japeral/Bedinino/hw/components/Jack Barrel to screw adapter, arduino power from wires/barrel jack adapter to screw.JPG

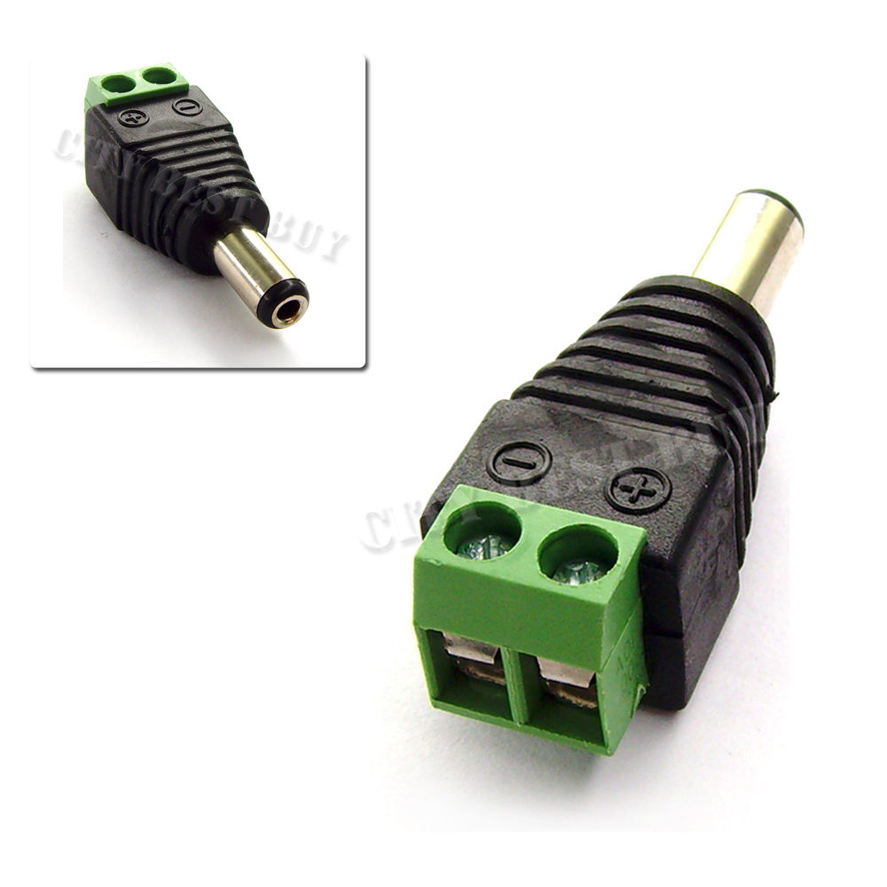
hw/components/Jack Barrel to screw adapter, arduino power from wires/barrel jack adapter to screw.JPG
