japeral/Bedinino/hw/components/Deepcycle Lead GEL Battery/Xuncell 12V 8Ah Solarx.jpg

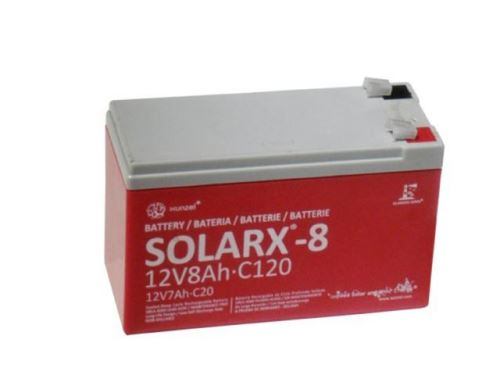
hw/components/Deepcycle Lead GEL Battery/Xuncell 12V 8Ah Solarx.jpg
