japeral/Bedinino/sw/Bedinino_timedbatteryswitcher_4x20LCD_4xDPDT/Bedinino TimedBatterySwitcher_schematic_4x20LCD_4xDPDT.docx

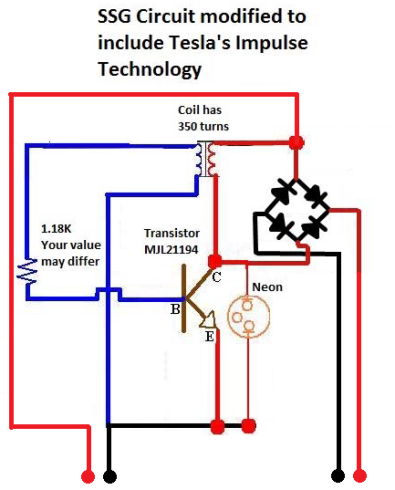
[picture p3: figure]

Output (Secondary)

Input (Primary)

B4

B3

B2

B1

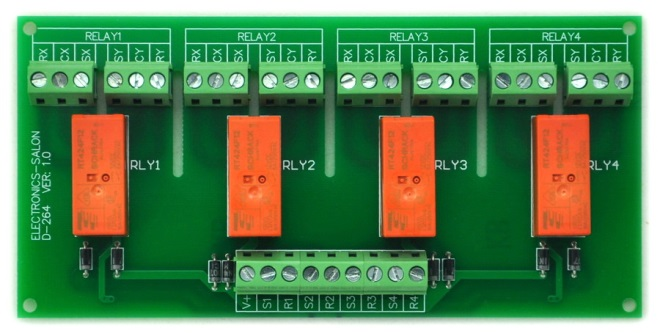
[picture p4: figure]

Isolation barrier

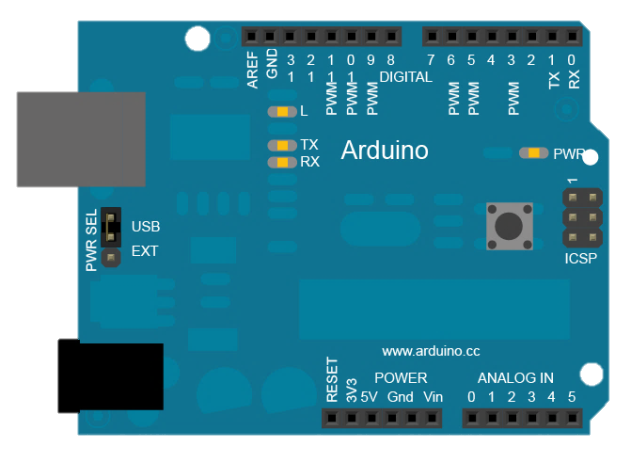
[picture p5: figure]

5V/1A USB Power Supply

For Arduino & Relays power

You need:

-Arduino UNO with this code:

(TODO)

- 1x latching 4x relay DPDT 8A 5V module.

Ebay: http://www.ebay.es/itm/131232400622?ssPageName=STRK:MEWAX:IT&_trksid=p3984.m1423.l2649

-Your Bedini monopole motor/energizer assembly and 4 batteries.

By J.A. Peral, 2014-07-12. japeralsoler@gmail.com It is a part of Bedinino project: www.github.com/japeral/Bedinino

Bedinino – Timed Battery Switcher +4x20LCD +4xDPDT v1.30
