japeral/Bedinino/sw/Bedinino_timedbatteryswitcher/Bedinino TimedBatterySwitcher_schematic.pdf

## Bedinino – Timed Battery Switcher v1.00

## Bedini monopole

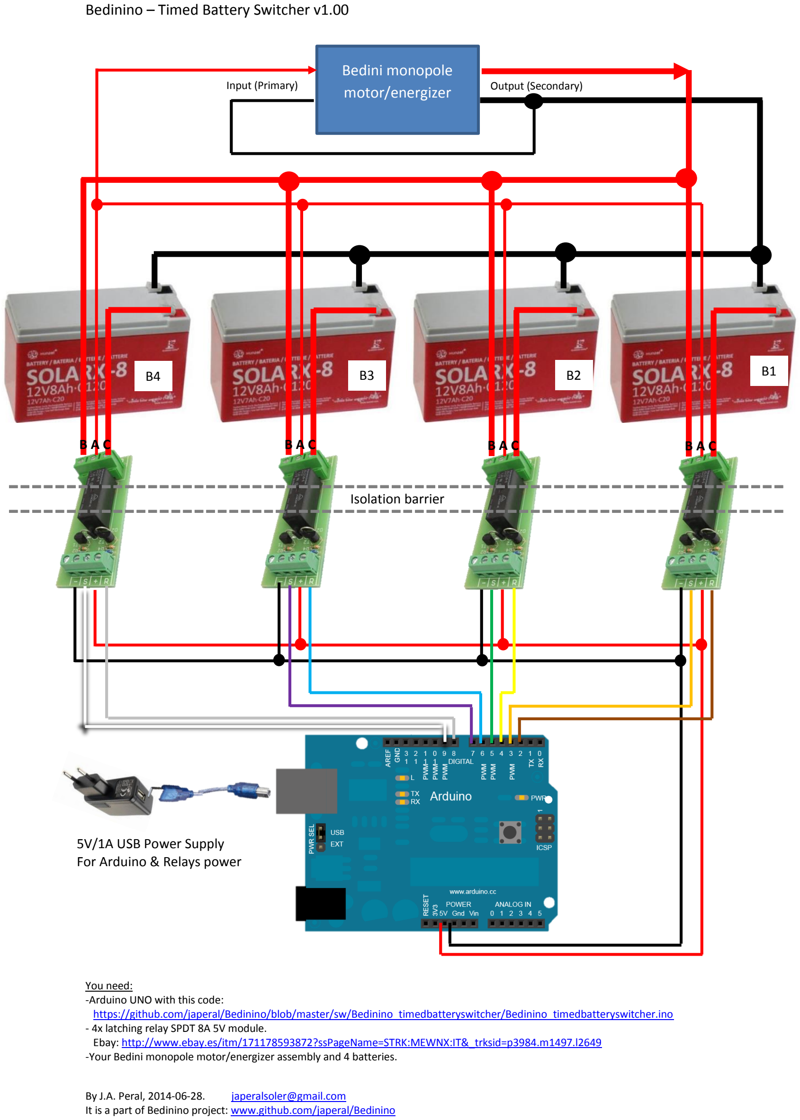
[picture p6: page 1]

By J.A. Peral, 2014-06-28. japeralsoler@gmail.com
It is a part of Bedinino project: www.github.com/japeral/Bedinino

You need:
-Arduino UNO with this code: https://github.com/japeral/Bedinino/blob/master/sw/Bedinino_timedbatteryswitcher/Bedinino_timedbatteryswitcher.ino
- 4x latching relay SPDT 8A 5V module.
Ebay: http://www.ebay.es/itm/171178593872?ssPageName=STRK:MEWNX:IT&_trksid=p3984.m1497.l2649
-Your Bedini monopole motor/energizer assembly and 4 batteries.
motor/energizer Input (Primary) | Output (Secondary)
B A C | B A C | B A C | B A C
B4 | B3 | B2

B1

### Isolation barrier

### 5V/1A USB Power Supply For Arduino & Relays power
