japeral/Bedinino/hw/components/Arduino uno ATMEGA328P pinout/ATMega168web.png

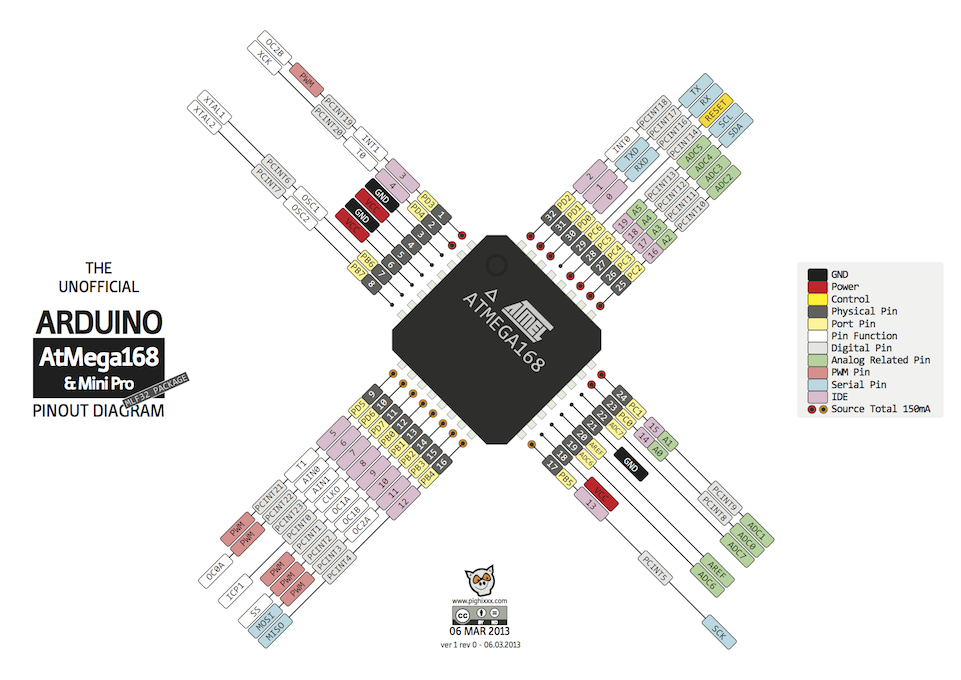
hw/components/Arduino uno ATMEGA328P pinout/ATMega168web.png
