japeral/Bedinino/hw/components/Magnetic sensor ratiometric/pinout & active area.jpg

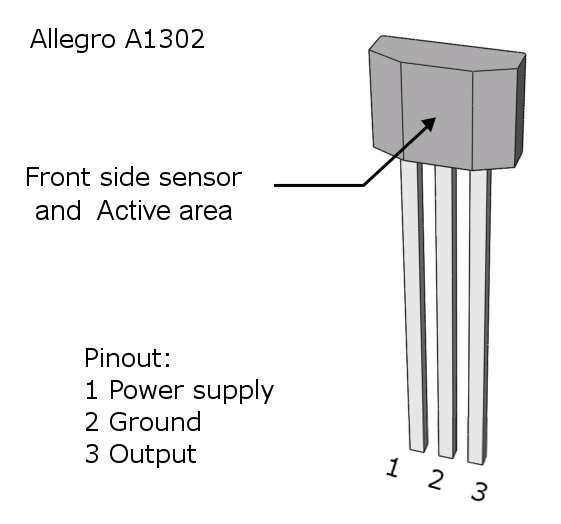
hw/components/Magnetic sensor ratiometric/pinout & active area.jpg
