japeral/Bedinino/hw/misc/12978_317747994994420_1342889042_n.jpg

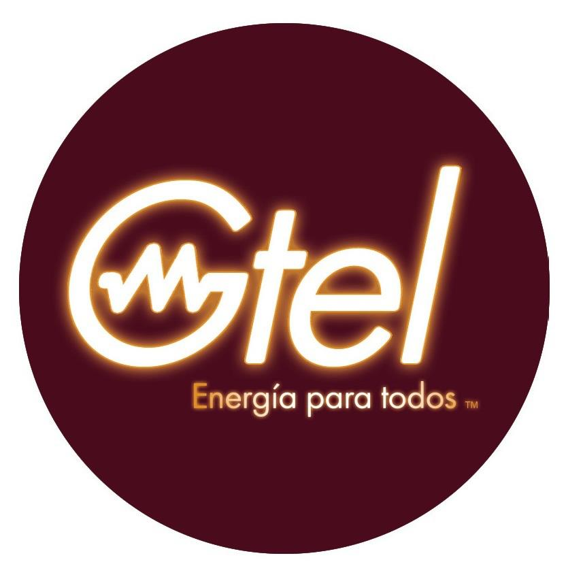
hw/misc/12978_317747994994420_1342889042_n.jpg
