japeral/Bedinino/hw/misc/gtel mono.bmp

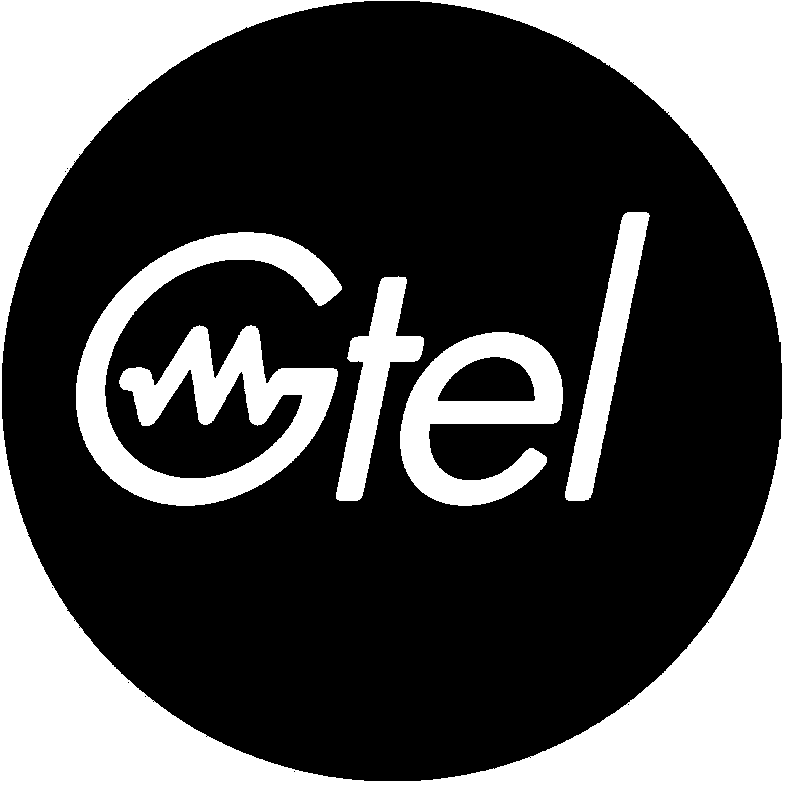
hw/misc/gtel mono.bmp
