japeral/Bedinino/hw/pcb/4 Battery Swap Shield (4BSS) rev.A/rev.A/4BSS rev.A v1/4BSS rev.A preview.png

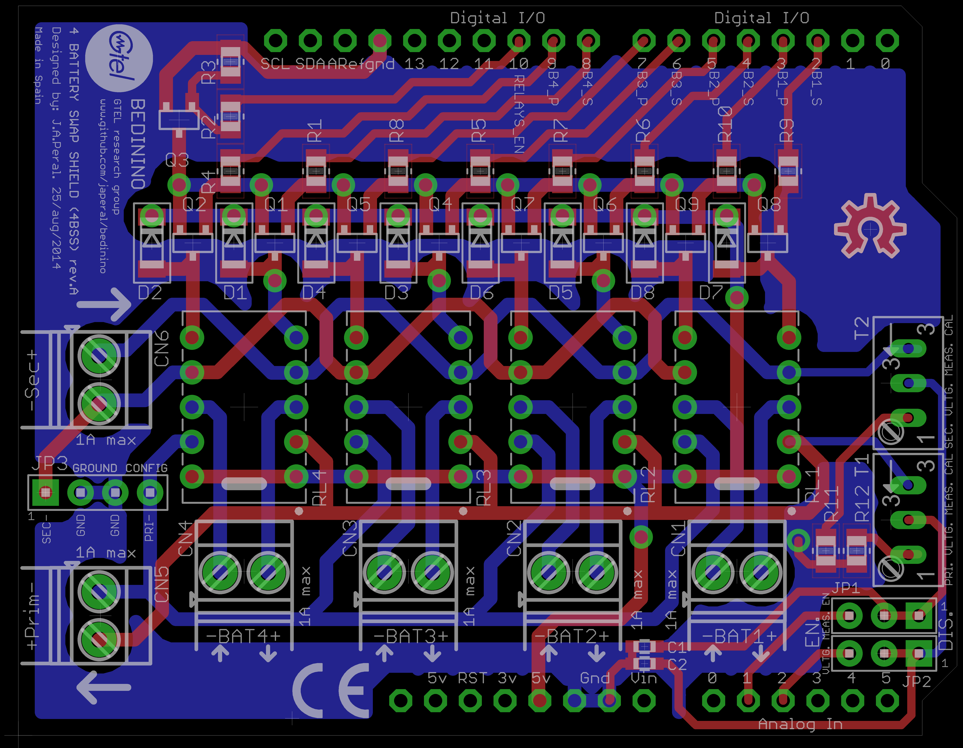
hw/pcb/4 Battery Swap Shield (4BSS) rev.A/rev.A/4BSS rev.A v1/4BSS rev.A preview.png
