japeral/Bedinino/hw/pcb/4 Battery Swap Shield (4BSS) rev.A/rev.A/4BSS rev.A v1/4bss rev.A TOP.png

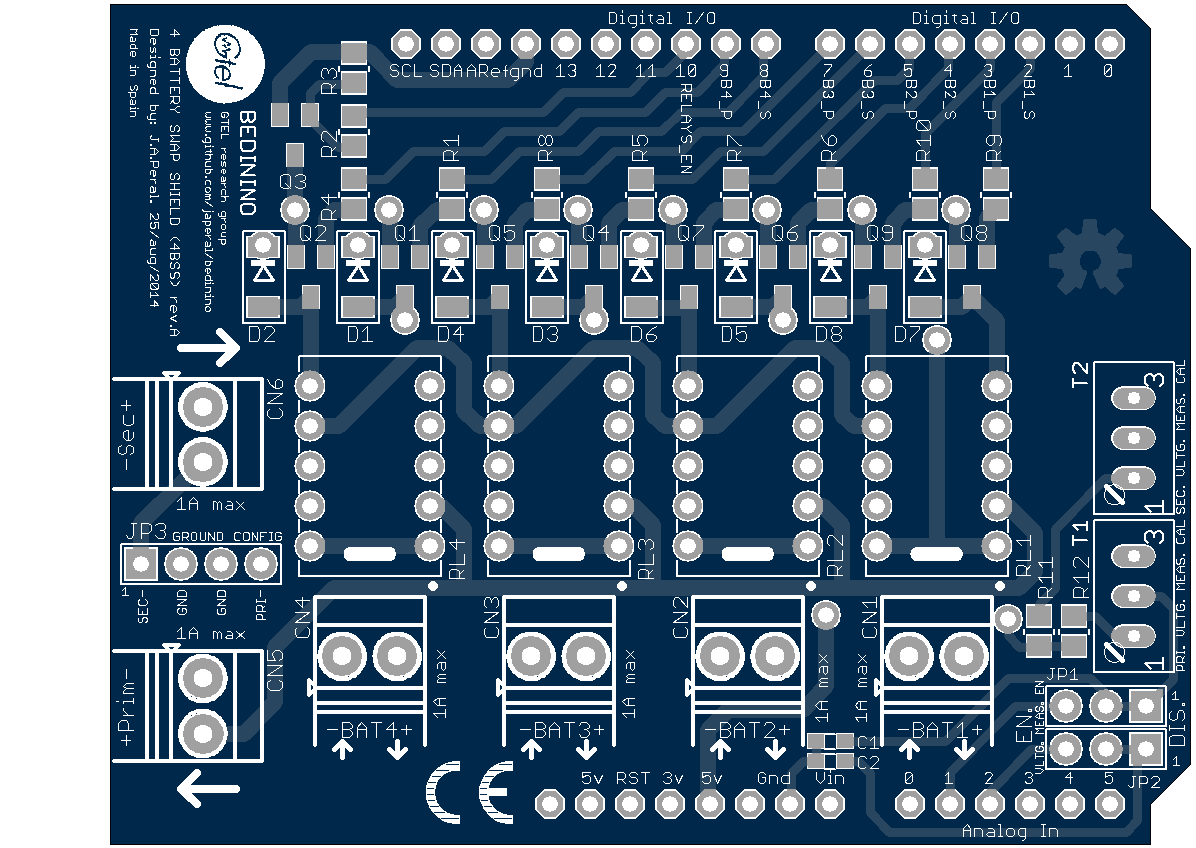
hw/pcb/4 Battery Swap Shield (4BSS) rev.A/rev.A/4BSS rev.A v1/4bss rev.A TOP.png
