japeral/Bedinino/hw/pcb/4 Battery Swap Shield (4BSS) rev.A/rev.A/Bedinino 4BSS schematic ebay.PNG

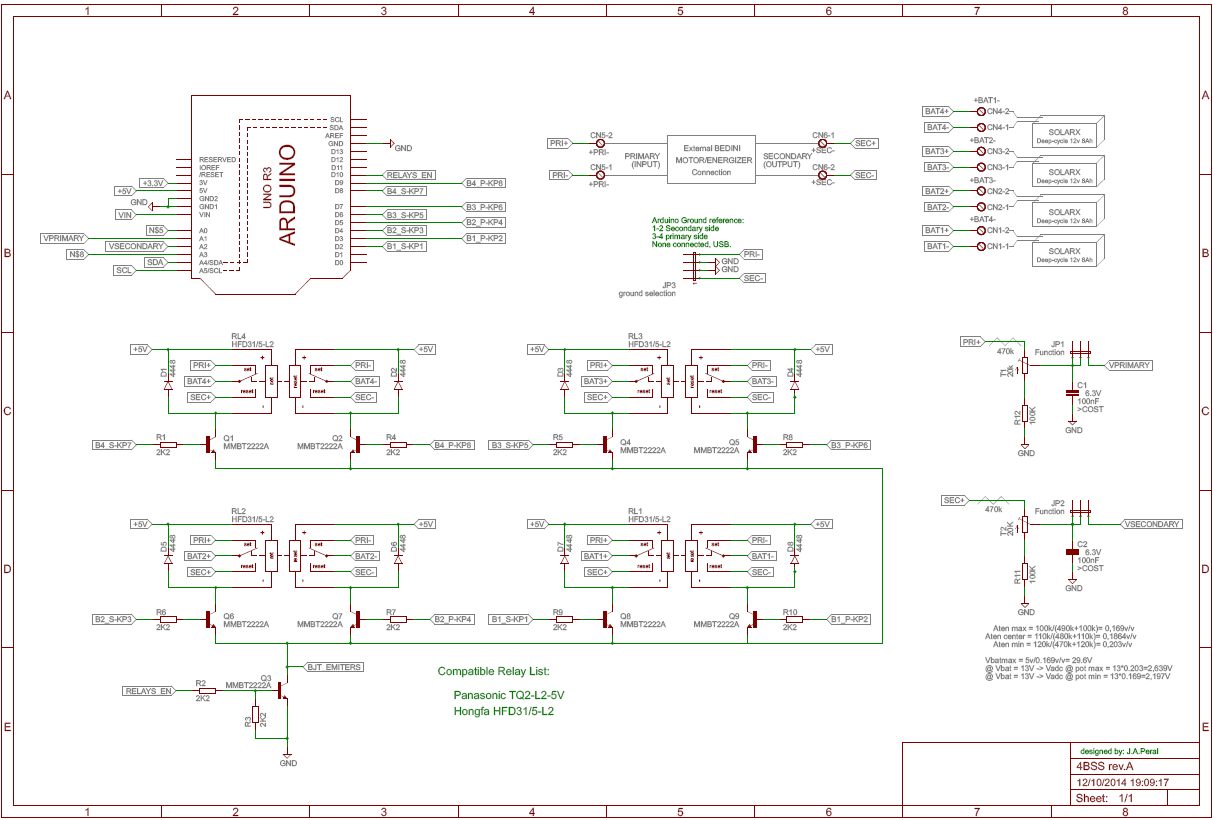
hw/pcb/4 Battery Swap Shield (4BSS) rev.A/rev.A/Bedinino 4BSS schematic ebay.PNG
