japeral/Bedinino/sw/Bedinino_4BSS_4x20LCD_TACHO/Bedinino_4BSS_4x20LCD_TACHO_v1.33/pinout & active area.jpg

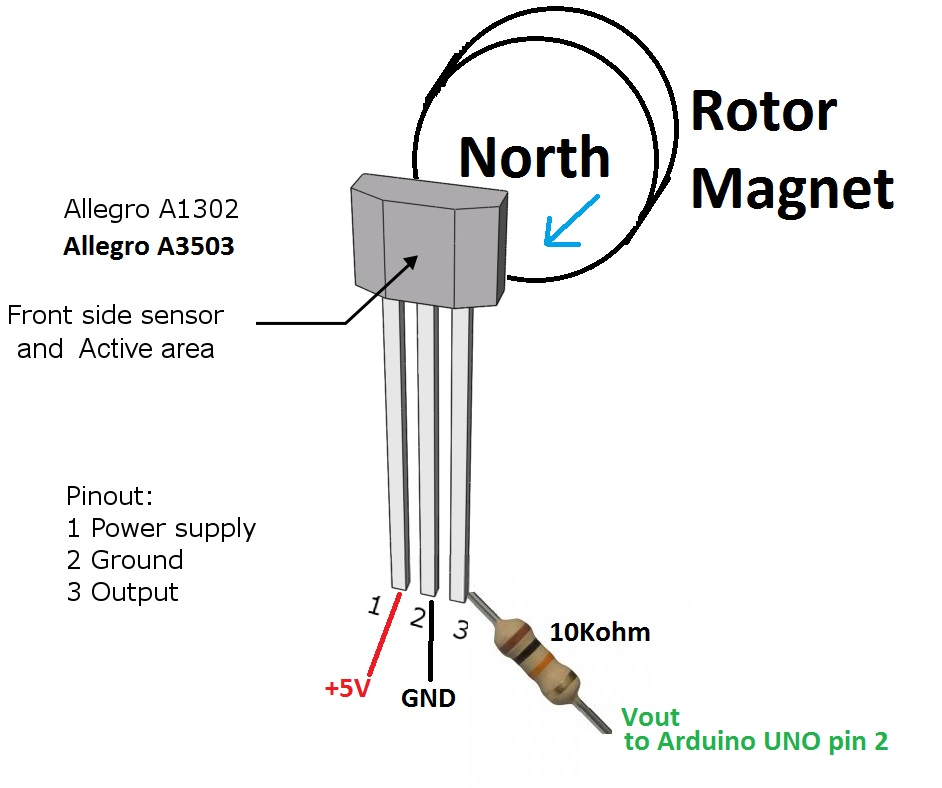
sw/Bedinino_4BSS_4x20LCD_TACHO/Bedinino_4BSS_4x20LCD_TACHO_v1.33/pinout & active area.jpg
