japeral/Bedinino/sw/Bedinino_timedbatteryswitcher/Bedini sugiere circuito que intercambia 4 baterias.PNG

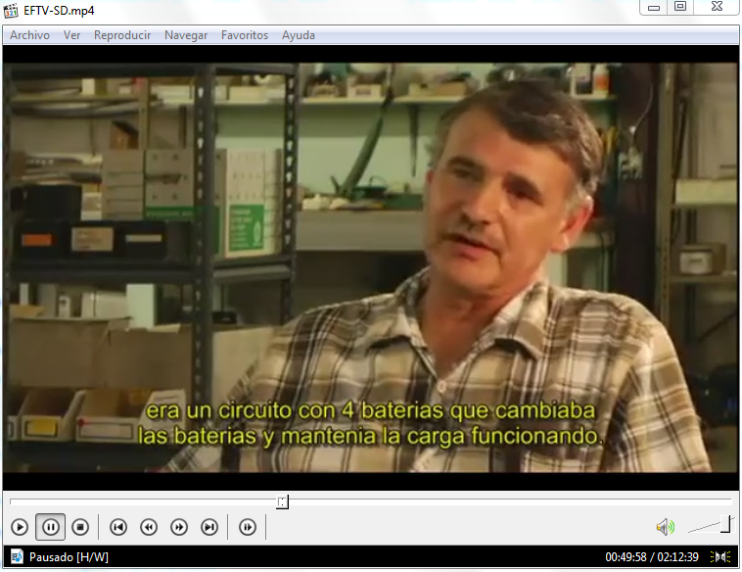
sw/Bedinino_timedbatteryswitcher/Bedini sugiere circuito que intercambia 4 baterias.PNG
