japeral/Bedinino/sw/Bedinino_timedbatteryswitcher_4x20LCD_4xDPDT/Bedinino v1.30.png

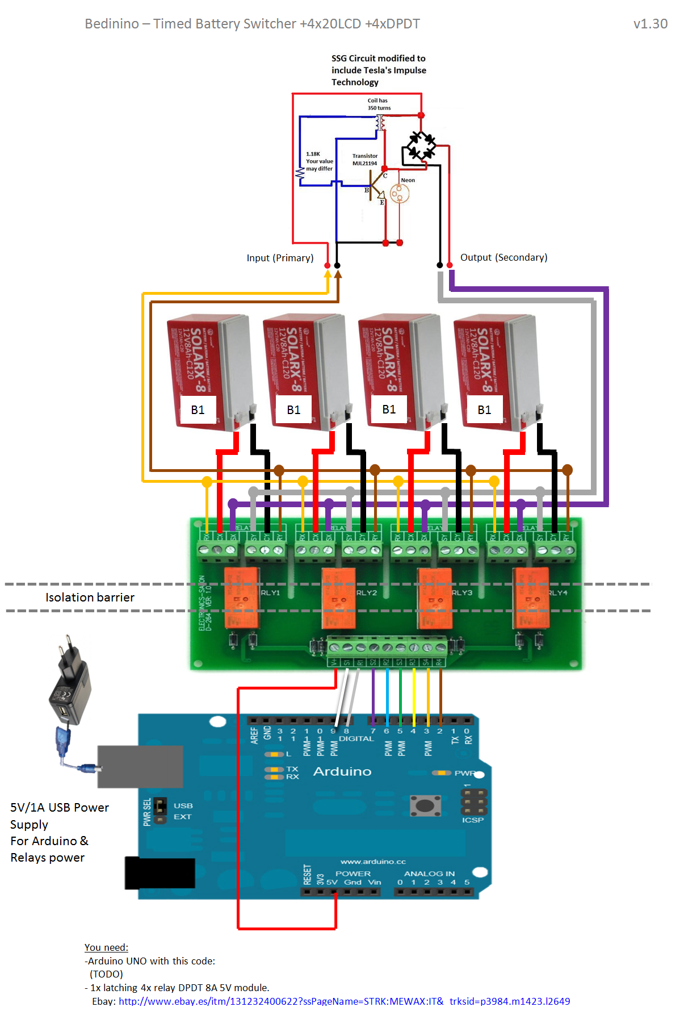
sw/Bedinino_timedbatteryswitcher_4x20LCD_4xDPDT/Bedinino v1.30.png
