japeral/Bedinino/sw/Bedinino_timedbatteryswitcher_4x20LCD_4xDPDT/D-262SCH.jpg

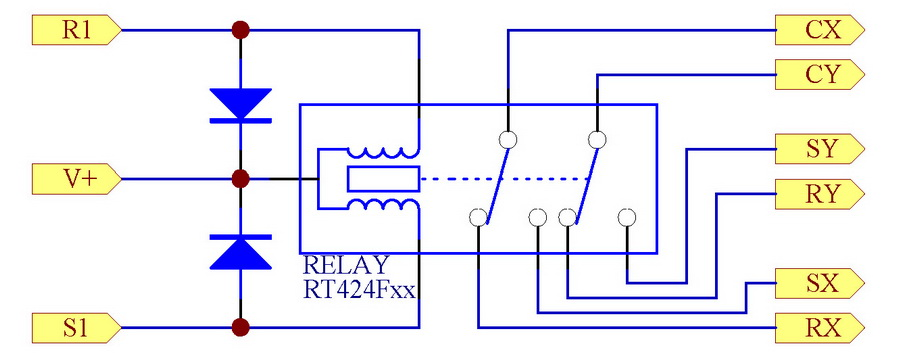
sw/Bedinino_timedbatteryswitcher_4x20LCD_4xDPDT/D-262SCH.jpg
