japeral/Bedinino/sw/Bedinino_timedbatteryswitcher_4x20LCD_4xDPDT/Passive Bistable Latching 4 DPDT 8 Amp Power Relay Module, 5V Version, RT424F05   eBay_files/spr15.png

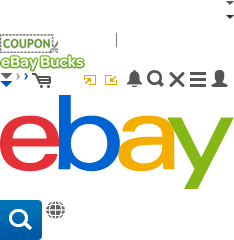
sw/Bedinino_timedbatteryswitcher_4x20LCD_4xDPDT/Passive Bistable Latching 4 DPDT 8 Amp Power Relay Module, 5V Version, RT424F05 eBay_files/spr15.png
