japeral/Bedinino/hw/Bill of Materials.xlsx

Description | Cost/pc | Number | Total
Arduino uno Clone | 5.43 € | 1 | 5.43 € | http://www.ebay.es/itm/NEW-CH340G-ATmega328P-UNO-R3-Board-Free-USB-Cable-for-Arduino-DIY-/141248769799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
DC/DC Buck converter | 1 € | 1 | 1 | http://www.ebay.es/itm/1pcs-DC-DC-Buck-Converter-Step-Down-Module-LM2596-Power-Supply-Output-1-23V-30V-/161102182049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
Latching Bistable Relay 5V | 7.33 € | 4 | 29.32 € | http://www.ebay.es/itm/Latching-Bistable-Relay-module-5V-Relay-board-for-AVR-PIC-Arduino-from-EU-/171178593872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
Arduino Uno Screw Shield | 3.37 € | 1 | 3.37 € | http://www.ebay.es/itm/Arduino-Screw-Shield-V1-expansion-board-set-for-DIY-is-compatible-with-UNO-R3-/271315401783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
Male-female 40 cable kit | 1.47 € | 1 | 1.47 € | http://www.ebay.es/itm/40pcs-20cm-2-54mm-Male-to-Female-Dupont-Wire-Jumper-Cable-for-Arduino-Breadboard-/360821413280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
Magnetic Sensor Hall effect ratiometric | 3.29 € | 5 | 0.66 € | http://www.ebay.es/itm/5Pcs-A1302-NEW-Ratiometric-Linear-Hall-Effect-Sensors-Chip-/310884565551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
Jack Barrel to screw adapter | 1.06 € | 2 | 0.53 € | http://www.ebay.es/itm/2-pcs-Male-5-5-x-2-1mm-DC-Power-Connector-Adapter-Jack-Plug-for-CCTV-Camera-/351092210138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
 |  | TOTAL | 41.78 €
Optional
12V 8Ah Deep cycle Gel / VRLA | 21.95 € | 2 | 43.90 € | http://www.ebay.es/itm/BATERIA-REFERENCIA-YPC8-12-DE-8AH-12V-BATERIA-DE-CALIDAD-YUASA-/181251963659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
Recomended equipment
M168 DIY Multimeter (inductance, capacitance, transistor… | 10.85 € | 1 | 10.85 € | http://www.ebay.es/itm/DIY-Kit-Capacitance-ESR-Inductance-Resistor-LC-Meter-Tester-NPN-PNP-Mosfet-M168-/281262386306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
Laser Photo Tachometer RMP Tester | 8.62 € | 1 | 8.62 € | http://www.ebay.es/itm/New-Digital-Laser-Photo-Tachometer-Non-Contact-RPM-Tach-Tester-RPM-Motors-/161114545438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
200mA analog ampmeter | 3.59 € | 2 | 7.18 € | http://www.ebay.es/itm/DC-200mA-Ampmeter-Analog-Current-Panel-Meter-Ammeter-0-200mA-/271210797555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
