japeral/Bedinino/hw/pcb/4 Battery Swap Shield (4BSS) rev.A/rev.A/4BSS rev.A Bill of Materials BOM.xls

Qty | Value | Device | Package | Parts | Description
6 | 1776275-2 |  | 3.5MMPITCH_2WAY | CN4 | CONNECTOR, Terminal Block, 2 pos, Side entry, Screw, 3.5mm pitch
1 | 3296W-1-204LF | 3296W-1-204LF | W | T1 | POTENTIOMETER, Trimmer, Square, Multiturn, 25 +-2 Turn, Cermet, Top Adjustment, 3/8''
1 | 3296W-1-503LF | 3296W-1-503LF | W | T2 | POTENTIOMETER, Trimmer, Square, Multiturn, 25 +-2 Turn, Cermet, Top Adjustment, 3/8''
2 |  |  | 0603 | C1, C2 | CAPACITOR, 100nF, 50V, 0603, Ceramic multilayer, X7R, 10%
4 | HFD31/5-L2 | HFD31/5-L2 | HFD31 | RL1, RL2, RL3, RL4 | Subminiature dual coil latching signal relay
8 | LS4448 | LS4448 | SOD-80C | D1, D2, D3, D4, D5, D6, D7, D8 | DIODE, Small signal, fast switching, IFSM=2A, IFRM=500mA, IF=300mA, SOD-80C
9 | MMBT2222A | MMBT2222A | SOT23 | Q1, Q2, Q3, Q4, Q5, Q6, Q7, Q8, Q9 | TRANSISTOR, BJT, NPN, General Purpose, Idmax=600, Vcemax=40V
2 |  |  | 0805 | R11, R12 | RESISTOR, General purpose resistor, 5%, 200v, 100ppm/ºC
10 |  |  | 0805 | R1, R2, R3, R4, R5, R6, R7, R8, R9, R10 | RESISTOR, General purpose resistor, 5%, 200v, 100ppm/ºC
2 |  |  | 3WAY-2.54MM | JP1, JP2 | HEADER MALE PIN, 1Row, 3 Way.
1 |  |  | 4WAY-2.54MM | JP3 | HEADER MALE PIN, 1Row, 4 Way.
