japeral/Bedinino/hw/components/Deepcycle Lead GEL Battery/Yuasa 12V 8Ah GEL Deepcycle YPC-12.JPG

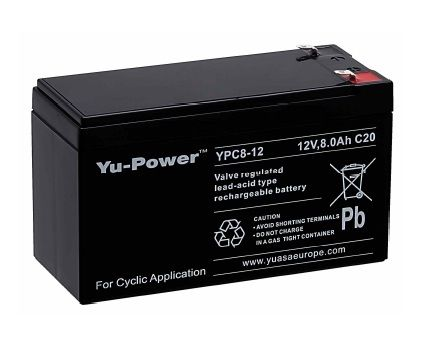
hw/components/Deepcycle Lead GEL Battery/Yuasa 12V 8Ah GEL Deepcycle YPC-12.JPG
