japeral/Bedinino/hw/pcb/4 Battery Swap Shield (4BSS) rev.A/rev.A/4BSS rev.A Schematic.pdf

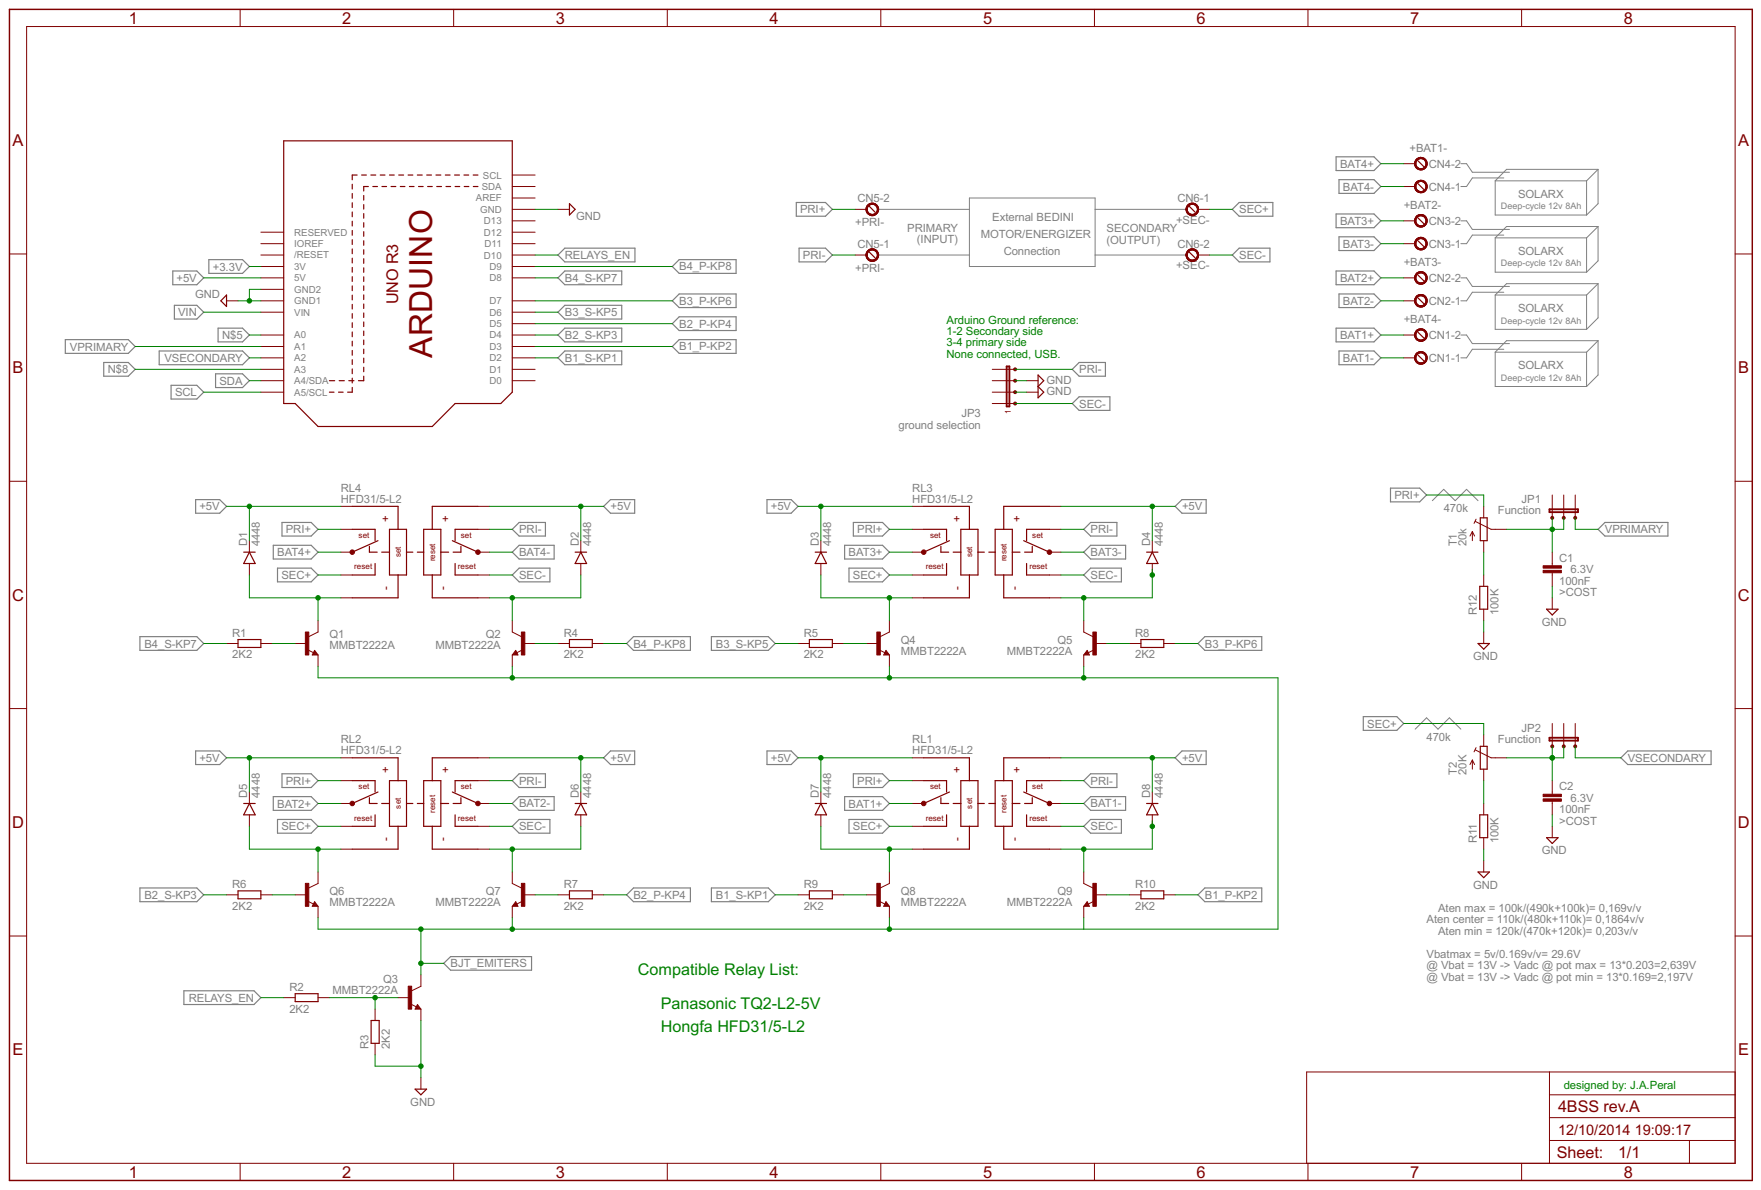
[picture p27: page 1]

External BEDINI MOTOR/ENERGIZER

Arduino Ground reference: None connected, USB. 1-2 Secondary side

Aten min = 120k/(470k+120k)= 0,203v/v Aten max = 100k/(490k+100k)= 0,169v/v @ Vbat = 13V -> Vadc @ pot min = 13*0.169=2,197V
Aten center = 110k/(480k+110k)= 0,1864v/v

Vbatmax = 5v/0.169v/v= 29.6V
@ Vbat = 13V -> Vadc @ pot max = 13*0.203=2,639V

Compatible Relay List: Panasonic TQ2-L2-5V
