japeral/Bedinino/hw/pcb/4 Battery Swap Shield (4BSS) rev.A/rev.A/4BSS rev.A.sch

## EAGLE design hw/pcb/4 Battery Swap Shield (4BSS) rev.A/rev.A/4BSS rev.A.sch (2014-10-12)

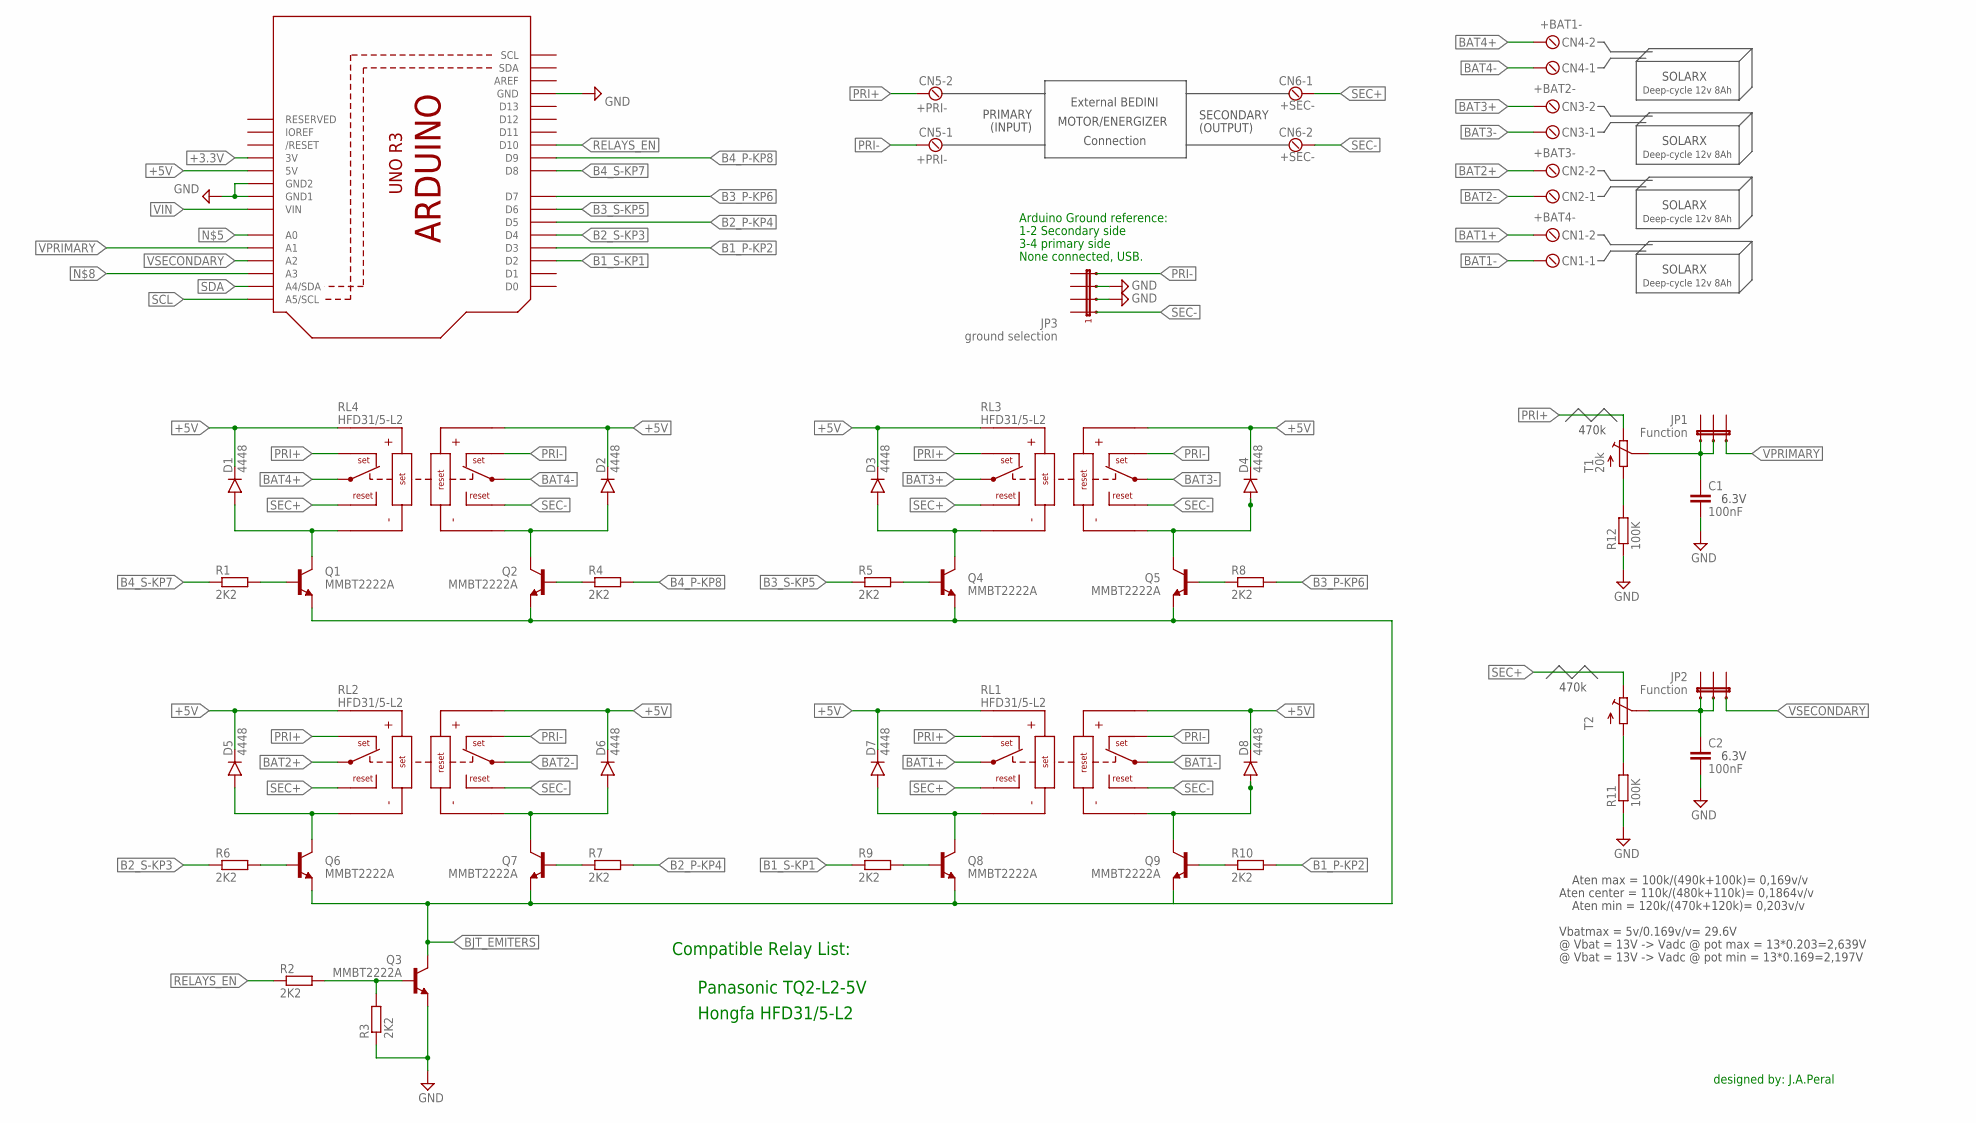
[picture p28: schematic 4BSS rev.A.sch]

Parts:
C1, C2: CL10B105KQ8NNNC; 0603
CN1, CN2, CN3, CN4, CN5, CN6: 1776275-2; TERMINALBLOCK_3.5MMPITCH_2WAY
D1, D2, D3, D4, D5, D6, D7, D8: LS4448; SOD-80C
JP1, JP2: TSW-103-07-T-S; 3WAY-2.54MM
JP3: TSW-104-07-T-S; 4WAY-2.54MM
Q1, Q2, Q3, Q4, Q5, Q6, Q7, Q8, Q9: MMBT2222A; SOT23
R1, R2, R3, R4, R5, R6, R7, R8, R9, R10: RC0805JR-072K2L; 0805
R11, R12: RC0805JR-07100KL; 0805
RL1, RL2, RL3, RL4: HFD31/5-L2; HFD31
T1: 3296W-1-204LF; W
T2: 3296W-1-503LF; W
U1: ARDUINOR3-NOHOLES; ARDUINO-NOHOLESR3

Connections:
+3.3V: U1.3V
+5V: D1.C, D2.C, D3.C, D4.C, D5.C, D6.C, D7.C, D8.C, RL1.1, RL1.10, RL2.1, RL2.10, RL3.1, RL3.10, RL4.1, RL4.10, U1.5V
B1_P-KP2: R10.2, U1.D3
B1_S-KP1: R9.1, U1.D2
B2_P-KP4: R7.2, U1.D5
B2_S-KP3: R6.1, U1.D4
B3_P-KP6: R8.2, U1.D7
B3_S-KP5: R5.1, U1.D6
B4_P-KP8: R4.2, U1.D9
B4_S-KP7: R1.1, U1.D8
BAT1+: CN1.2, RL1.3
BAT1-: CN1.1, RL1.8
BAT2+: CN2.2, RL2.3
BAT2-: CN2.1, RL2.8
BAT3+: CN3.2, RL3.3
BAT3-: CN3.1, RL3.8
BAT4+: CN4.2, RL4.3
BAT4-: CN4.1, RL4.8
BJT_EMITERS: Q1.2 (E), Q2.2 (E), Q3.3 (C), Q4.2 (E), Q5.2 (E), Q6.2 (E), Q7.2 (E), Q8.2 (E), Q9.2 (E)
GND: C1.2, C2.2, JP3.2, JP3.3, Q3.2 (E), R3.1, R11.1, R12.1, U1.GND, U1.GND1, U1.GND2
unnamed: Q1.1 (B), R1.2
unnamed: D3.A, Q4.3 (C), RL3.5
unnamed: D4.A, Q5.3 (C), RL3.6
unnamed: Q2.1 (B), R4.1
unnamed: C2.1, JP2.1, JP2.2, T2.S
unnamed: C1.1, JP1.1, JP1.2, T1.S
unnamed: D1.A, Q1.3 (C), RL4.5
unnamed: D2.A, Q2.3 (C), RL4.6
unnamed: R12.2, T1.A
unnamed: D5.A, Q6.3 (C), RL2.5
unnamed: Q4.1 (B), R5.2
unnamed: Q5.1 (B), R8.1
unnamed: Q3.1 (B), R2.2, R3.2
unnamed: D6.A, Q7.3 (C), RL2.6
unnamed: Q6.1 (B), R6.2
unnamed: Q7.1 (B), R7.1
unnamed: D7.A, Q8.3 (C), RL1.5
unnamed: D8.A, Q9.3 (C), RL1.6
unnamed: Q8.1 (B), R9.2
unnamed: Q9.1 (B), R10.1
unnamed: R11.2, T2.A
PRI+: CN5.2, RL1.2, RL2.2, RL3.2, RL4.2, T1.E
PRI-: CN5.1, JP3.4, RL1.9, RL2.9, RL3.9, RL4.9
RELAYS_EN: R2.1, U1.D10
SCL: U1.A5 (A5/SCL)
SDA: U1.A4 (A4/SDA)
SEC+: CN6.1, RL1.4, RL2.4, RL3.4, RL4.4, T2.E
SEC-: CN6.2, JP3.1, RL1.7, RL2.7, RL3.7, RL4.7
VIN: U1.VIN
VPRIMARY: JP1.3, U1.A1
VSECONDARY: JP2.3, U1.A2

Notes on the sheet:
External BEDINI
MOTOR/ENERGIZER
PRIMARY
SECONDARY
(INPUT)
(OUTPUT)
SOLARX
Deep-cycle 12v 8Ah
Connection
Arduino Ground reference:
None connected, USB.
1-2 Secondary side
3-4 primary side
Compatible Relay List:
Panasonic TQ2-L2-5V
@ Vbat = 13V -> Vadc @ pot max = 13*0.203=2,639V
470k
Aten min = 120k/(470k+120k)= 0,203v/v
Aten max = 100k/(490k+100k)= 0,169v/v
@ Vbat = 13V -> Vadc @ pot min = 13*0.169=2,197V
Vbatmax = 5v/0.169v/v= 29.6V
Aten center = 110k/(480k+110k)= 0,1864v/v
Hongfa HFD31/5-L2
designed by: J.A.Peral
