japeral/Bedinino/(commit log)

2014-06-09 Bedinino
    First upload
    [Bill of Materials.xlsx]
2014-06-09 none
    none
    [Bill of Materials.xlsx]
2014-06-23 First issue for timed battery switcher
    First issue for timed battery switcher
    [Bedinino_timedbatteryswitcher.ino]
2014-06-28 Added TimedBatterySwitcher schematic
    Latching relay modules detailed power and wiring to arduino
2014-07-05 v1.10 added
    added vprimary and vsecondary adquisition and swap event by voltaje
    instead by fixed time.
    [Bill of Materials.xlsx, Sensors.xlsx]
2014-07-05 v1.20 added
    Some improvements
    [Sensors.xlsx]
2014-07-12 v1.30 4xDPDT relay module added
    4 bat positive and negative pole switching to primary and secondary
    side. You need a x4 DPDT relay module.
2014-10-12 Bedinino 4BSS rev.A v1.30 release
    Bedinino 4BSS 4x20 LCD v1.30 released
    [4BSS rev.A.sch]
2014-10-12 added BOM and sch in pdf format
    [4BSS rev.A Bill of Materials BOM.csv, 4BSS rev.A.sch]
2014-10-12 added bom in xls format
    [4BSS rev.A Bill of Materials BOM.csv, 4BSS rev.A Bill of Materials BOM.xls]
2014-10-18 added folders for each version and v1.31
    v1.31 swapping battery number selectable from 2 to 4.
    [Bedinino_4BSS_4x20LCD_v1.30.ino, Bedinino_4BSS_4x20LCD_v1.31.ino]
2014-10-27 v1.32 added
    - Included Liquid Cristal I2C Arduino library.
    * Added elapsed time counter. Up to 49 day 12 hour (unsigned long
    counting ms rollover).
    * Added swap counter.
    [Bedinino_4BSS_4x20LCD_v1.32.ino]
2014-11-05 Added v1.33 with tachometer
    Tachometer function added!
    [Sensors.xlsx]
2018-06-16 Update 4BSS rev.A Board.txt
